el-nikitos/OCP-2/OCP-2/PNG/OCP-2-монтаж.png

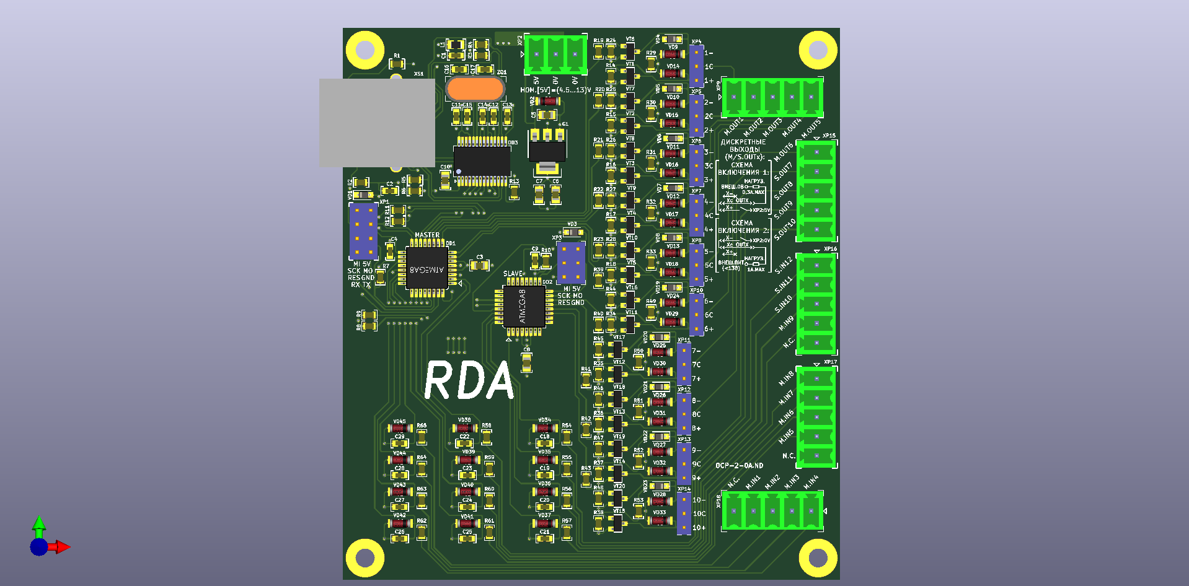
OCP-2/PNG/OCP-2-монтаж.png
