el-nikitos/OCP-2/OCP-2/PNG/OCP-2-F-ZOOM.png

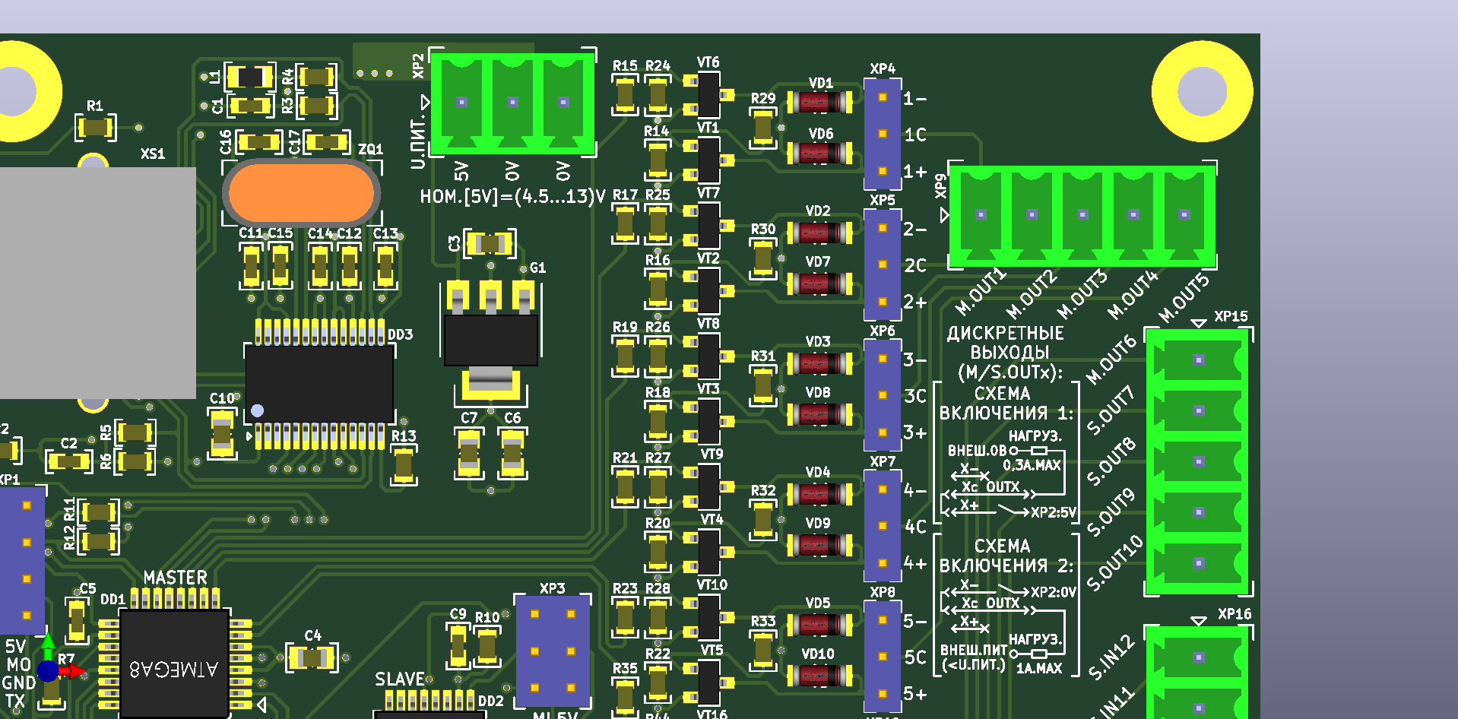
OCP-2/PNG/OCP-2-F-ZOOM.png
