el-nikitos/OCP-2/OCP-2/DWF/OCP-2-Edge_Cuts.dxf

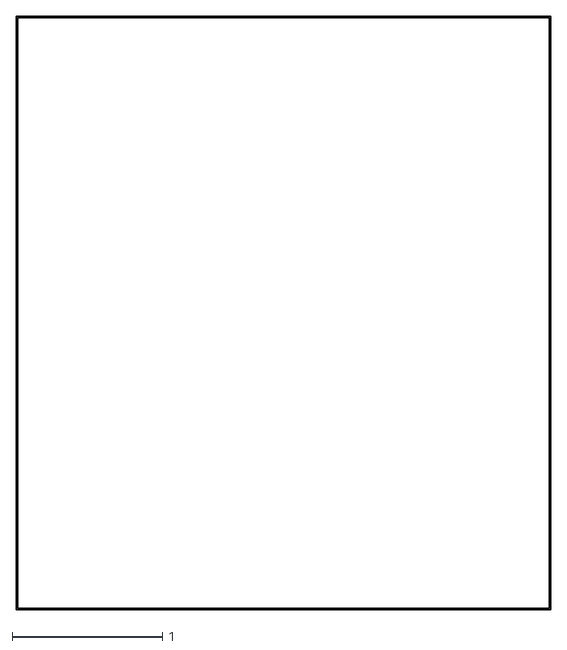
[picture p6: CAD file, 2021-12-19]
OCP-2/DWF/OCP-2-Edge_Cuts.dxf
3.56 x 3.95
