el-nikitos/OCP-2/OCP-2/OCP-2.pdf

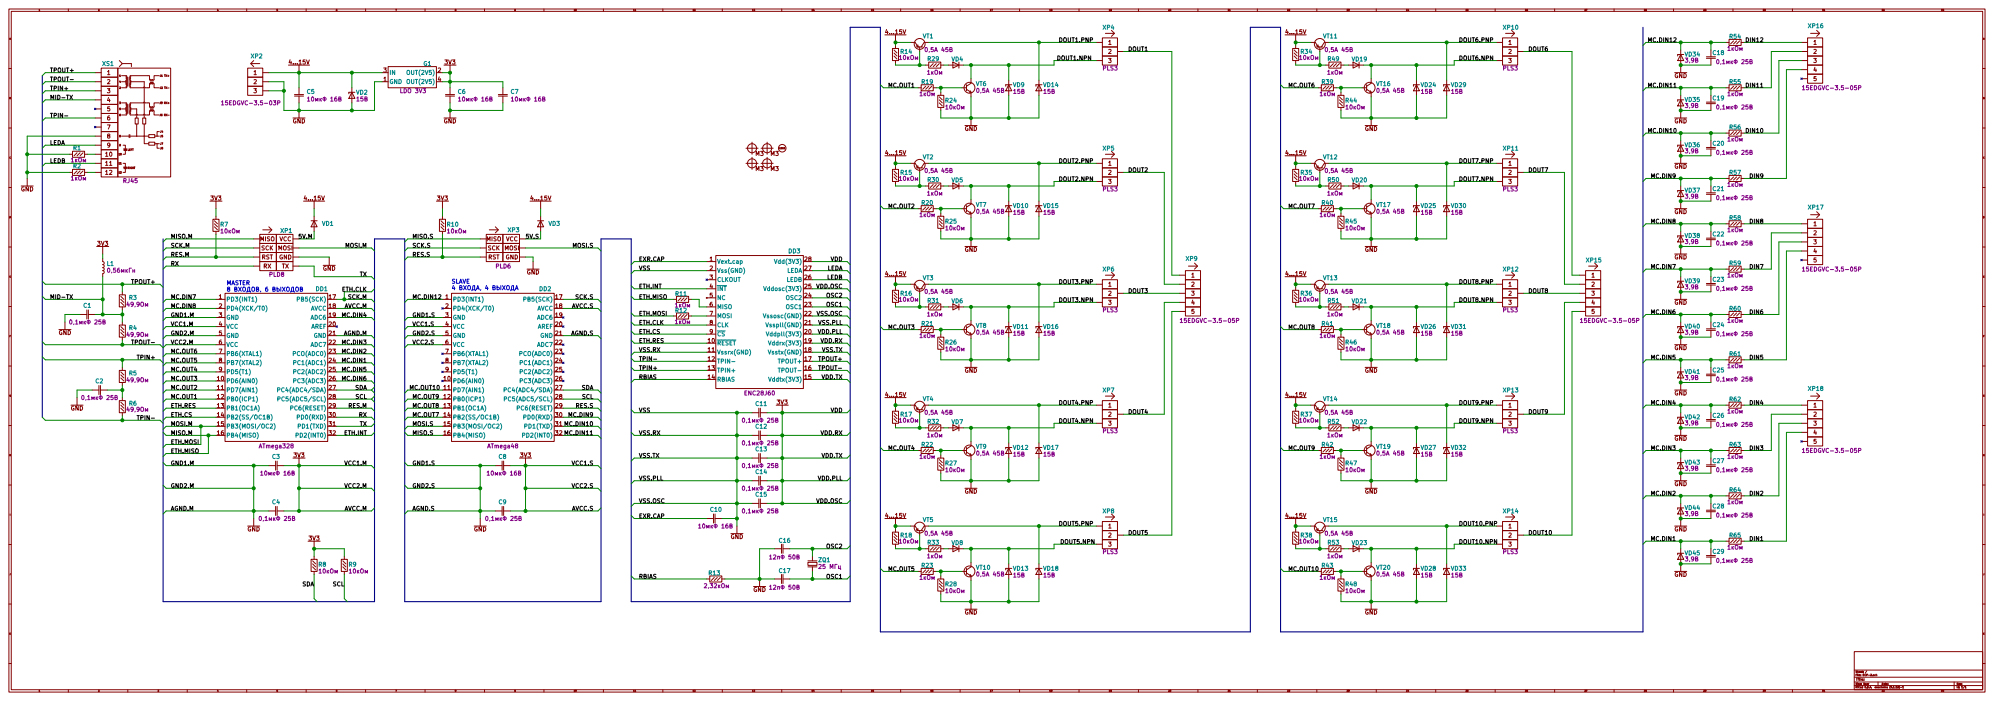
[picture p7: page 1]

Id: 1/1 Title: File: OCP-2.sch Sheet: / C4
