el-nikitos/OCP-2/OCP-2/OCP-2.kicad_pcb

## KiCad design OCP-2/OCP-2.kicad_pcb (2021-12-12)

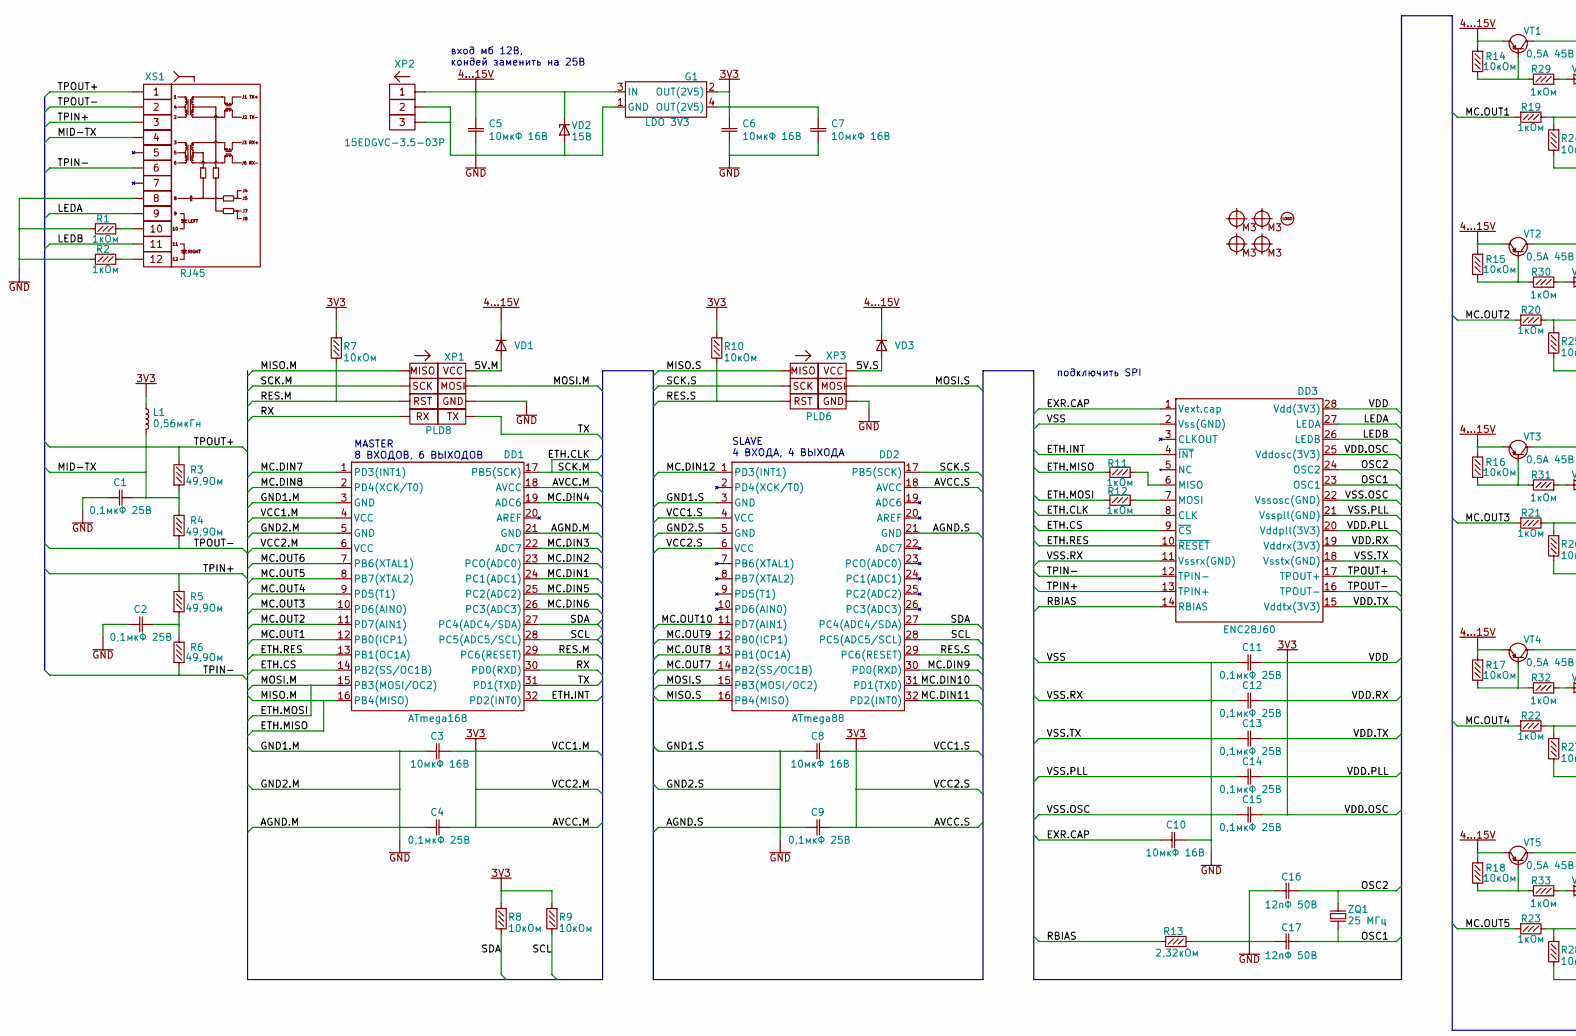
[picture p8: schematic OCP-2.sch, part in row 1, column 1]

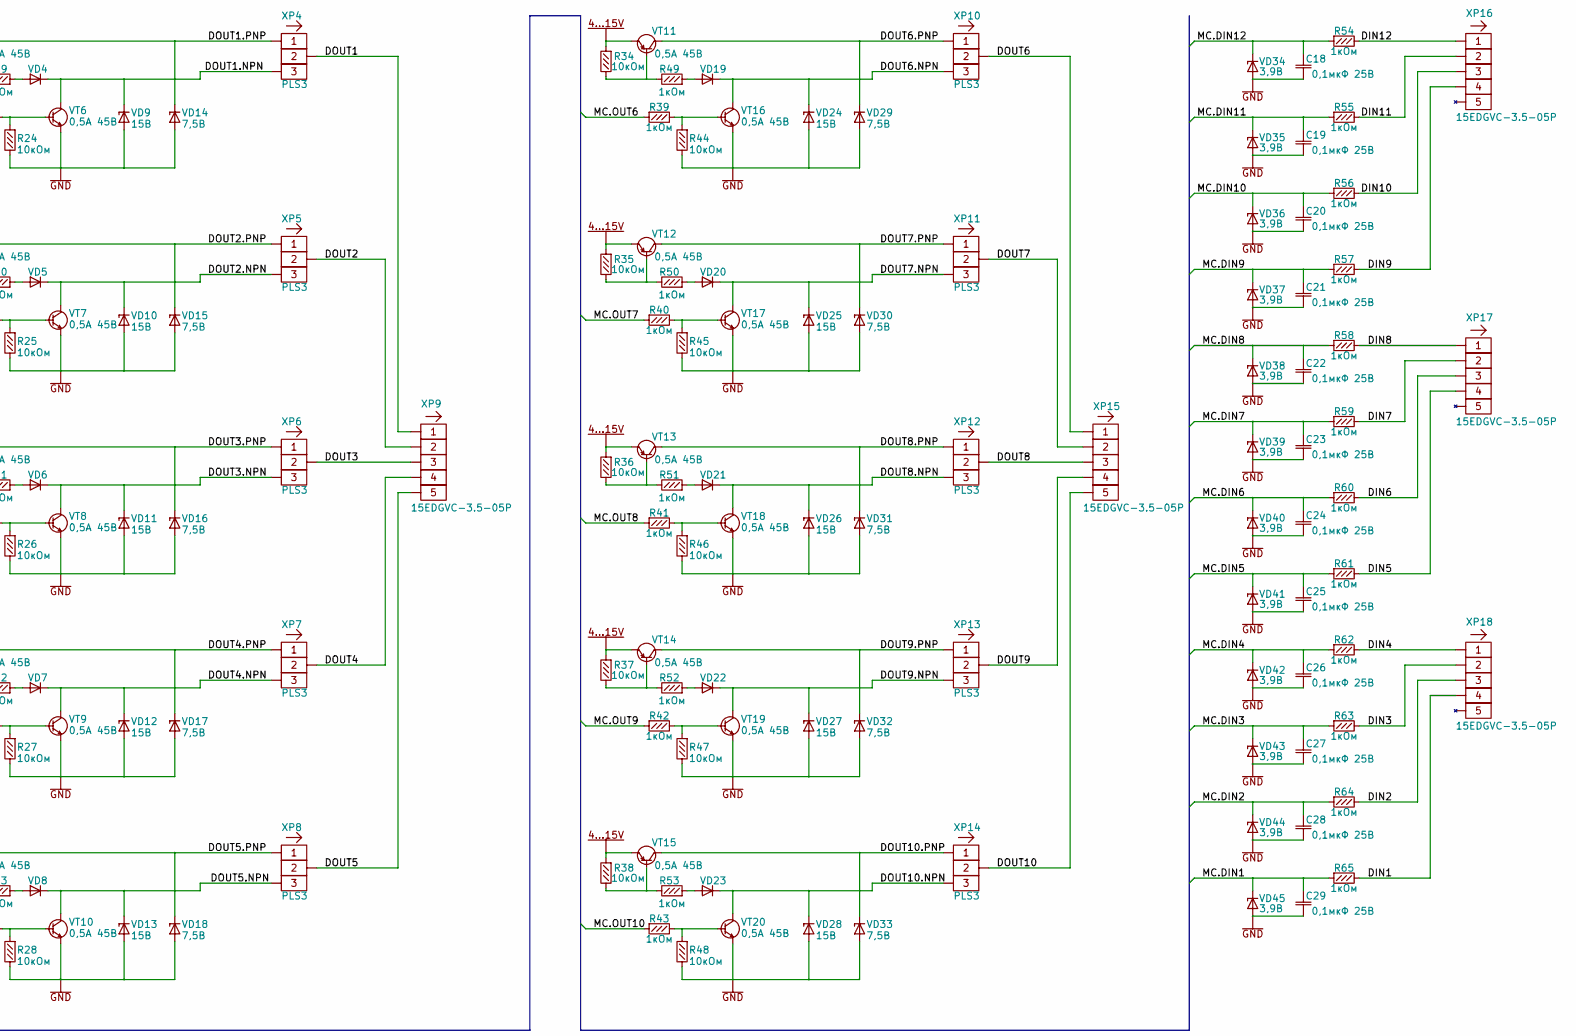
[picture p9: schematic OCP-2.sch, part in row 1, column 2]

Parts:
C1, C2, C4, C9, C11, C12, C13, C14, C15, C18, C19, C20, C21, C22, C23, C24, C25, C26, C27, C28, C29: Конденсатор*0,1мкФ*25В*0603; Конденсатор_SMD_IEC_0603
C3, C5, C6, C7, C8, C10: Конденсатор*10мкФ*16В*0805; Конденсатор_SMD_IEC_0805
C16, C17: Конденсатор*12пФ*50В*0603; Конденсатор_SMD_IEC_0603
DD1: МК*ATmega168*TQFP32; микросхема_ATMEGA-8-161AU
DD2: МК*ATmega88*TQFP32; микросхема_ATMEGA-8-161AU
DD3: Преобразователь*ETH-SPI*SSOP28; SSOP-28
G1: LDO*вход_18Вmax*выход_3,3В*ток_1,2АSOT-223; Транзистор_NPN_SOT223_pnp
L1: Чип-индуктивность*0,56мкГн*150мА*0805; Резистор_SMD_IEC_0805_0,125_Вт
R1, R2, R11, R12, R19, R20, R21, R22, R23, R29, R30, R31, R32, R33, R39, R40, R41, R42, R43, R49, R50, R51, R52, R53, R54, R55, R56, R57, R58, R59, R60, R61, R62, R63, R64, R65: Резистор*1кОм*0603; Резистор_SMD_0603_0,065_Вт_pnp
R3, R4, R5, R6: Резистор*49,9кОм*0603; Резистор_SMD_0603_0,065_Вт_pnp
R7, R8, R9, R10, R14, R15, R16, R17, R18, R24, R25, R26, R27, R28, R34, R35, R36, R37, R38, R44, R45, R46, R47, R48: Резистор*10кОм*0603; Резистор_SMD_0603_0,065_Вт_pnp
R13: Резистор*2,32кОм*0603; Резистор_SMD_0603_0,065_Вт_pnp
VD1, VD3, VD4, VD5, VD6, VD7, VD8, VD19, VD20, VD21, VD22, VD23: Диод*75В*0,2А*SOD-323; D_SOD-323_HandSoldering
VD2, VD9, VD10, VD11, VD12, VD13, VD14, VD15, VD16, VD17, VD18, VD24, VD25, VD26, VD27, VD28, VD29, VD30, VD31, VD32, VD33: Стабилитрон*7,5В*SOD80; SOD-80
VD34, VD35, VD36, VD37, VD38, VD39, VD40, VD41, VD42, VD43, VD44, VD45: Стабилитрон*3,9В*SOD80; SOD-80
VT1, VT2, VT3, VT4, VT5, VT11, VT12, VT13, VT14, VT15: Транзистор*pnp*0,5А*45В*SOT23; Корпус_КТ-46
VT6, VT7, VT8, VT9, VT10, VT16, VT17, VT18, VT19, VT20: Транзистор*npn*0,5А*45В*SOT23; Корпус_КТ-46
X1, X2, X3, X4: ico*отверстие*М3; Отверстие_М3
X5: ico*LOGO_NIKITOS_10х10; ni_10x10
XP1: Вилка*PLD*8контактов*2ряда*вертикальная*AVR+UART; Вилка_PLD8_вертикальная_AB
XP2: Клеммник*шаг_3,5*3контактов*1ряд*вертикальная; Клеммник_15EDGVC-3.5-03P
XP3: Вилка*PLD*6контактов*2ряда*вертикальная*AVR; Вилка_PLD6_вертикальная_AB
XP4, XP5, XP6, XP7, XP8, XP10, XP11, XP12, XP13, XP14: Вилка*PLS*3контактов*1ряд*вертикальная; Вилка_PLS3_вертикальная
XP9, XP15, XP16, XP17, XP18: Клеммник*шаг_3,5*5контактов*1ряд*вертикальная; Клеммник_15EDGVC-3.5-05P
XS1: Розетка*ETH+трансформатор*8p8c; Розетка_ETH_KLS12-TL002
ZQ1: Резонатор*25МГц*HC-49U; Резонатор_РК456МДУ(DIP)

Connections:
3V3: C3.1, C4.1, C6.1, C7.1, C8.1, C9.1, C11.1, C12.1, C13.1, C14.1, C15.1, DD1.4 (VCC), DD1.6 (VCC), DD1.18 (AVCC), DD2.4 (VCC), DD2.6 (VCC), DD2.18 (AVCC), DD3.15 (Vddtx(3V3)), DD3.19 (Vddrx(3V3)), DD3.20 (Vddpll(3V3)), DD3.25 (Vddosc(3V3)), DD3.28 (Vdd(3V3)), G1.2 (OUT(2V5)), G1.4 (OUT(2V5)), L1.1, R7.1, R8.1, R9.1, R10.1
4...15V: C5.1, G1.3 (IN), R14.1, R15.1, R16.1, R17.1, R18.1, R34.1, R35.1, R36.1, R37.1, R38.1, VD1.1, VD2.2, VD3.1, VT1.2, VT2.2, VT3.2, VT4.2, VT5.2, VT11.2, VT12.2, VT13.2, VT14.2, VT15.2, XP2.1
/5V.M: VD1.2, XP1.1B
/5V.S: VD3.2, XP3.1B
/DIN1: R65.2, XP18.4
/DIN2: R64.2, XP18.3
/DIN3: R63.2, XP18.2
/DIN4: R62.2, XP18.1
/DIN5: R61.2, XP17.4
/DIN6: R60.2, XP17.3
/DIN7: R59.2, XP17.2
/DIN8: R58.2, XP17.1
/DIN9: R57.2, XP16.4
/DIN10: R56.2, XP16.3
/DIN11: R55.2, XP16.2
/DIN12: R54.2, XP16.1
/DOUT1: XP4.2, XP9.1
/DOUT1.NPN: VD4.1, VD9.2, VT6.3, XP4.3
/DOUT1.PNP: VD14.2, VT1.3, XP4.1
/DOUT2: XP5.2, XP9.2
/DOUT2.NPN: VD5.1, VD10.2, VT7.3, XP5.3
/DOUT2.PNP: VD15.2, VT2.3, XP5.1
/DOUT3: XP6.2, XP9.3
/DOUT3.NPN: VD6.1, VD11.2, VT8.3, XP6.3
/DOUT3.PNP: VD16.2, VT3.3, XP6.1
/DOUT4: XP7.2, XP9.4
/DOUT4.NPN: VD7.1, VD12.2, VT9.3, XP7.3
/DOUT4.PNP: VD17.2, VT4.3, XP7.1
/DOUT5: XP8.2, XP9.5
/DOUT5.NPN: VD8.1, VD13.2, VT10.3, XP8.3
/DOUT5.PNP: VD18.2, VT5.3, XP8.1
/DOUT6: XP10.2, XP15.1
/DOUT6.NPN: VD19.1, VD24.2, VT16.3, XP10.3
/DOUT6.PNP: VD29.2, VT11.3, XP10.1
/DOUT7: XP11.2, XP15.2
/DOUT7.NPN: VD20.1, VD25.2, VT17.3, XP11.3
/DOUT7.PNP: VD30.2, VT12.3, XP11.1
/DOUT8: XP12.2, XP15.3
/DOUT8.NPN: VD21.1, VD26.2, VT18.3, XP12.3
/DOUT8.PNP: VD31.2, VT13.3, XP12.1
/DOUT9: XP13.2, XP15.4
/DOUT9.NPN: VD22.1, VD27.2, VT19.3, XP13.3
/DOUT9.PNP: VD32.2, VT14.3, XP13.1
/DOUT10: XP14.2, XP15.5
/DOUT10.NPN: VD23.1, VD28.2, VT20.3, XP14.3
/DOUT10.PNP: VD33.2, VT15.3, XP14.1
/ETH.CLK: DD1.17 (PB5(SCK)), DD3.8 (CLK), XP1.2A
/ETH.CS: DD1.14 (PB2(SS/OC1B)), DD3.9 (~CS)
/ETH.INT: DD1.32 (PD2(INT0)), DD3.4 (~INT)
/ETH.MISO: DD1.16 (PB4(MISO)), R11.2, XP1.1A
/ETH.MOSI: DD1.15 (PB3(MOSI/OC2)), R12.2, XP1.2B
/ETH.RES: DD1.13 (PB1(OC1A)), DD3.10 (~RESET)
/EXR.CAP: C10.2, DD3.1 (Vext.cap)
/LEDA: DD3.27 (LEDA), XS1.9
/LEDB: DD3.26 (LEDB), XS1.11
/MC.DIN1: C29.2, DD1.24 (PC1(ADC1)), R65.1, VD45.2
/MC.DIN2: C28.2, DD1.23 (PCO(ADC0)), R64.1, VD44.2
/MC.DIN3: C27.2, DD1.22 (ADC7), R63.1, VD43.2
/MC.DIN4: C26.2, DD1.19 (ADC6), R62.1, VD42.2
/MC.DIN5: C25.2, DD1.25 (PC2(ADC2)), R61.1, VD41.2
/MC.DIN6: C24.2, DD1.26 (PC3(ADC3)), R60.1, VD40.2
/MC.DIN7: C23.2, DD1.1 (PD3(INT1)), R59.1, VD39.2
/MC.DIN8: C22.2, DD1.2 (PD4(XCK/T0)), R58.1, VD38.2
/MC.DIN9: C21.2, DD2.30 (PD0(RXD)), R57.1, VD37.2
/MC.DIN10: C20.2, DD2.31 (PD1(TXD)), R56.1, VD36.2
/MC.DIN11: C19.2, DD2.32 (PD2(INT0)), R55.1, VD35.2
/MC.DIN12: C18.2, DD2.1 (PD3(INT1)), R54.1, VD34.2
/MC.OUT1: DD1.12 (PB0(ICP1)), R19.1
/MC.OUT2: DD1.11 (PD7(AIN1)), R20.1
/MC.OUT3: DD1.10 (PD6(AIN0)), R21.1
/MC.OUT4: DD1.9 (PD5(T1)), R22.1
/MC.OUT5: DD1.8 (PB7(XTAL2)), R23.1
/MC.OUT6: DD1.7 (PB6(XTAL1)), R39.1
/MC.OUT7: DD2.14 (PB2(SS/OC1B)), R40.1
/MC.OUT8: DD2.13 (PB1(OC1A)), R41.1
/MC.OUT9: DD2.12 (PB0(ICP1)), R42.1
/MC.OUT10: DD2.11 (PD7(AIN1)), R43.1
/MID-TX: C1.1, L1.2, R3.1, R4.2, XS1.4
/MISO.S: DD2.16 (PB4(MISO)), XP3.1A
/MOSI.S: DD2.15 (PB3(MOSI/OC2)), XP3.2B
/OSC1: C17.1, DD3.23 (OSC1), ZQ1.2
/OSC2: C16.1, DD3.24 (OSC2), ZQ1.1
/RBIAS: DD3.14 (RBIAS), R13.1
/RES.M: DD1.29 (PC6(RESET)), R7.2, XP1.3A
/RES.S: DD2.29 (PC6(RESET)), R10.2, XP3.3A
/RX: DD1.30 (PD0(RXD)), XP1.4A
/SCK.S: DD2.17 (PB5(SCK)), XP3.2A
/SCL: DD1.28 (PC5(ADC5/SCL)), DD2.28 (PC5(ADC5/SCL)), R9.2
/SDA: DD1.27 (PC4(ADC4/SDA)), DD2.27 (PC4(ADC4/SDA)), R8.2
/TPIN+: DD3.13 (TPIN+), R5.2, XS1.3
/TPIN-: DD3.12 (TPIN-), R6.1, XS1.6
/TPOUT+: DD3.17 (TPOUT+), R3.2, XS1.1
/TPOUT-: DD3.16 (TPOUT-), R4.1, XS1.2
/TX: DD1.31 (PD1(TXD)), XP1.4B
GND: C1.2, C2.2, C3.2, C4.2, C5.2, C6.2, C7.2, C8.2, C9.2, C10.1, C11.2, C12.2, C13.2, C14.2, C15.2, C16.2, C17.2, C18.1, C19.1, C20.1, C21.1, C22.1, C23.1, C24.1, C25.1, C26.1, C27.1, C28.1, C29.1, DD1.3 (GND), DD1.5 (GND), DD1.21 (GND), DD2.3 (GND), DD2.5 (GND), DD2.21 (GND), DD3.2 (Vss(GND)), DD3.11 (Vssrx(GND)), DD3.18 (Vsstx(GND)), DD3.21 (Vsspll(GND)), DD3.22 (Vssosc(GND)), G1.1 (GND), R1.2, R2.2, R13.2, R24.2, R25.2, R26.2, R27.2, R28.2, R44.2, R45.2, R46.2, R47.2, R48.2, VD2.1, VD9.1, VD10.1, VD11.1, VD12.1, VD13.1, VD14.1, VD15.1, VD16.1, VD17.1, VD18.1, VD24.1, VD25.1, VD26.1, VD27.1, VD28.1, VD29.1, VD30.1, VD31.1, VD32.1, VD33.1, VD34.1, VD35.1, VD36.1, VD37.1, VD38.1, VD39.1, VD40.1, VD41.1, VD42.1, VD43.1, VD44.1, VD45.1, VT6.2, VT7.2, VT8.2, VT9.2, VT10.2, VT16.2, VT17.2, VT18.2, VT19.2, VT20.2, XP1.3B, XP2.2, XP2.3, XP3.3B, XS1.8
unnamed: C2.1, R5.1, R6.2
unnamed: DD3.6 (MISO), R11.1
unnamed: DD3.7 (MOSI), R12.1
unnamed: R1.1, XS1.10
unnamed: R2.1, XS1.12
unnamed: R14.2, R29.2, VT1.1
unnamed: R15.2, R30.2, VT2.1
unnamed: R16.2, R31.2, VT3.1
unnamed: R17.2, R32.2, VT4.1
unnamed: R18.2, R33.2, VT5.1
unnamed: R19.2, R24.1, VT6.1
unnamed: R20.2, R25.1, VT7.1
unnamed: R21.2, R26.1, VT8.1
unnamed: R22.2, R27.1, VT9.1
unnamed: R23.2, R28.1, VT10.1
unnamed: R29.1, VD4.2
unnamed: R30.1, VD5.2
unnamed: R31.1, VD6.2
unnamed: R32.1, VD7.2
unnamed: R33.1, VD8.2
unnamed: R34.2, R49.2, VT11.1
unnamed: R35.2, R50.2, VT12.1
unnamed: R36.2, R51.2, VT13.1
unnamed: R37.2, R52.2, VT14.1
unnamed: R38.2, R53.2, VT15.1
unnamed: R39.2, R44.1, VT16.1
unnamed: R40.2, R45.1, VT17.1
unnamed: R41.2, R46.1, VT18.1
unnamed: R42.2, R47.1, VT19.1
unnamed: R43.2, R48.1, VT20.1
unnamed: R49.1, VD19.2
unnamed: R50.1, VD20.2
unnamed: R51.1, VD21.2
unnamed: R52.1, VD22.2
unnamed: R53.1, VD23.2

Notes on the sheet:
подключить SPI
MASTER 8 ВХОДОВ, 6 ВЫХОДОВ
SLAVE 4 ВХОДА, 4 ВЫХОДА
вход мб 12В, кондей заменить на 25В

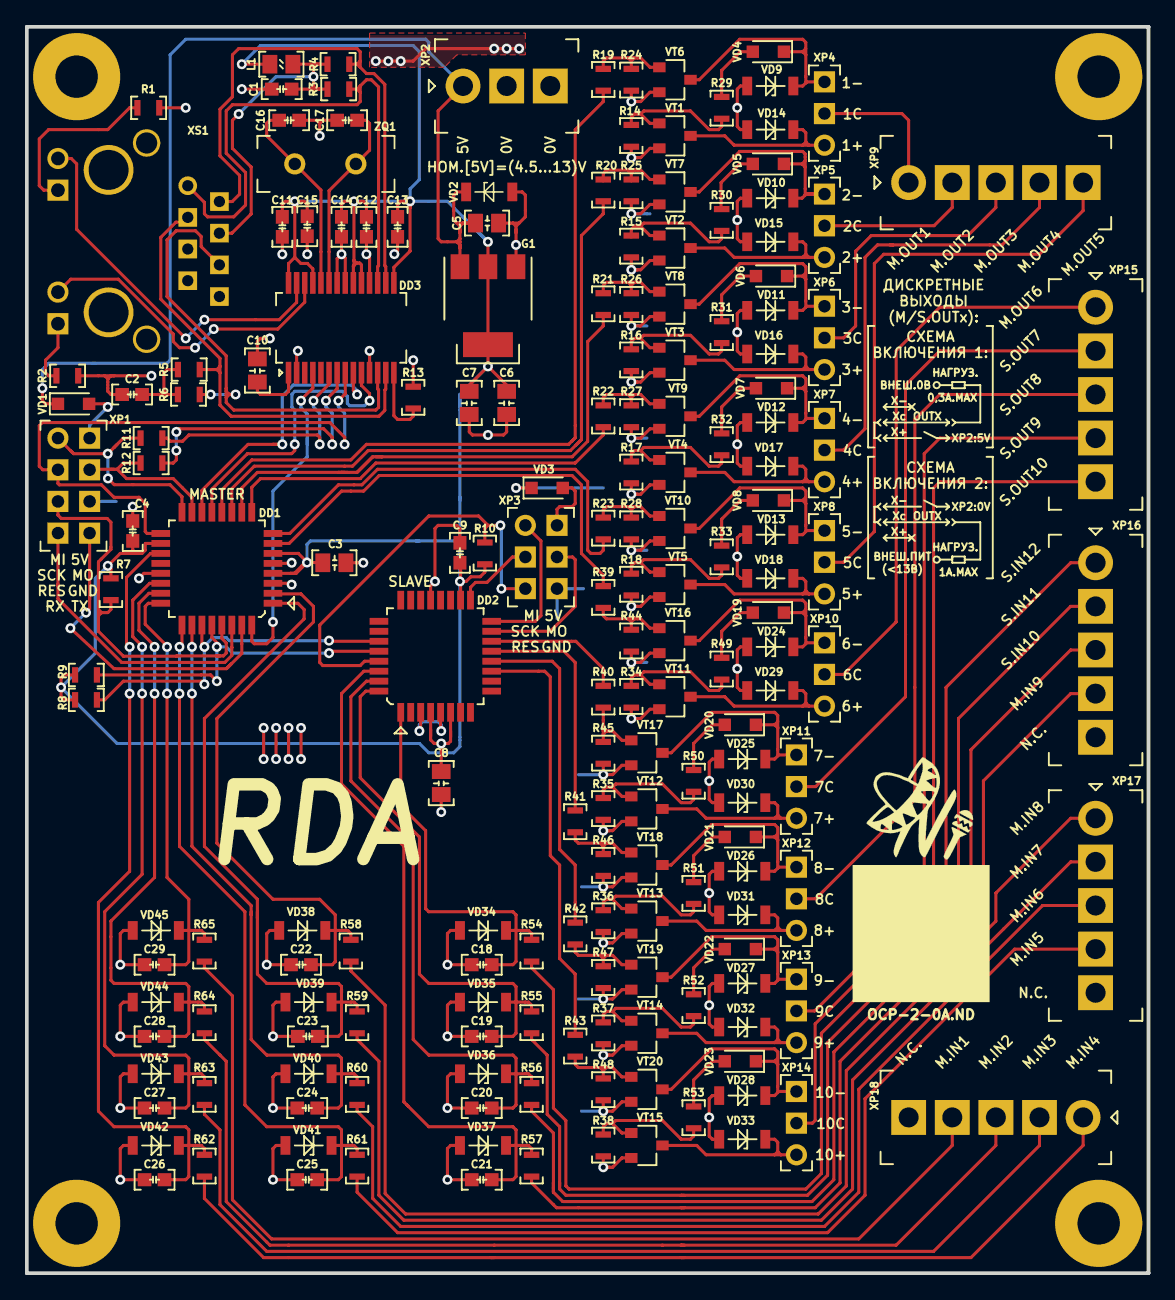
[picture p10: board OCP-2.kicad_pcb from above]

Board: 2 copper layers, 90.0 x 100.0 mm, 189 parts (0 on the bottom side), 130 nets.
