el-nikitos/OCP-2/(commit log)

2021-11-14 2 МК + ETH-SPI
    [OCP-2.kicad_pcb, OCP-2.sch]
2021-11-14 обвес питания МК и ETH
    [OCP-2.kicad_pcb, OCP-2.sch]
2021-11-20 схема DI и DO + трассировка
    [OCP-2.kicad_pcb, OCP-2.sch]
2021-11-21 размещена угловая розетка модуля
    [OCP-2.kicad_pcb, OCP-2.sch]
2021-11-21 размещена схема DI, схема не подбита
    [OCP-2.kicad_pcb, OCP-2.sch]
2021-12-01 изменена вилка программирования, вынесена розетка ETH
    [OCP-2.kicad_pcb, OCP-2.sch]
2021-12-02 схема подключения ETH без SPI и светодиодов
    [OCP-2.kicad_pcb, OCP-2.sch]
2021-12-03 полная схема подключен ETH и МК, нет клеммников
    [OCP-2.kicad_pcb, OCP-2.sch]
2021-12-05 схема включения ETH + клеммники вместо СНП306
    [OCP-2.kicad_pcb, OCP-2.sch]
2021-12-09 перенесены клеммники, +LDO, +прог.разъем, +МК расположение
    [OCP-2.kicad_pcb, OCP-2.sch]
2021-12-11 завершенеа трассировка
    [OCP-2.kicad_pcb, OCP-2.sch]
2021-12-11 добавлена поясняющая маркировка
    [OCP-2.kicad_pcb, OCP-2.sch]
2021-12-11 добавлены запирающие диоды в npn канал, обновлен step
    [OCP-2.kicad_pcb, OCP-2.sch]
2021-12-12 0А: добавлены диодная защита прог. + стабилитрон на входе питания
    [OCP-2.kicad_pcb, OCP-2.sch]
2021-12-12 OCP-2-0A-CU_only: добавлена пустая заливка обратной стороны
    [OCP-2-B_Cu.gbr, OCP-2-B_Mask.gbr, OCP-2-B_SilkS.gbr, OCP-2-Edge_Cuts.gbr, OCP-2-F_Cu.gbr, OCP-2-F_Mask.gbr, OCP-2-F_SilkS.gbr, OCP-2-NPTH.drl]
2021-12-19 ссылки в элементах исправлены под заказ
    [OCP-2-Edge_Cuts.dxf, OCP-2.sch]
2021-12-23 перечень ПКИ для КД
    [OCP-2.sch, перечень ПКИ.xlsx]
2021-12-28 управление DO1-4 через http
2021-12-29 определена кастомные функции работы с gpio
2021-12-30 все GPIO через кастомные функции +6 канал +логика перенесена в регистр
2021-12-30 добавлена рыба для дискретных входов, исправлена ошибка с битым символом
2022-01-01 настроены DI и DO для мастера + web-лицо
2022-01-01 добавлен вывод в HTML регистров
2022-01-06 i2c-slave din & dout + eth i2c-master
2022-01-07 начата описательная часть
2022-02-20 файлы для подключения кастомных плат
2022-02-27 обновлена документация, добавлена резервная копия avrdude
